SpacehuhnTech/HackHeld/README.md

# HackHeld

Here you can find all the hardware files for the HackHeld project. 

Visit [hackheld.spacehuhn.com](https://hackheld.spacehuhn.com) for more information.
