SpacehuhnTech/HackHeld/HackHeld Vega/Hackheld_Vega_Case/Hackheld_Vega_Case.stl

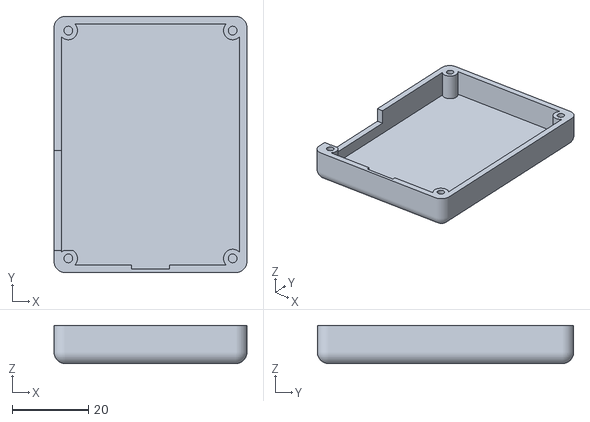
[picture p4: CAD file, 2021-08-06]
HackHeld Vega/Hackheld_Vega_Case/Hackheld_Vega_Case.stl
50.5 x 67.1 x 9.99
