SpacehuhnTech/HackHeld/HackHeld Vega/Hackheld_Vega_PCB/3D/OLED.step

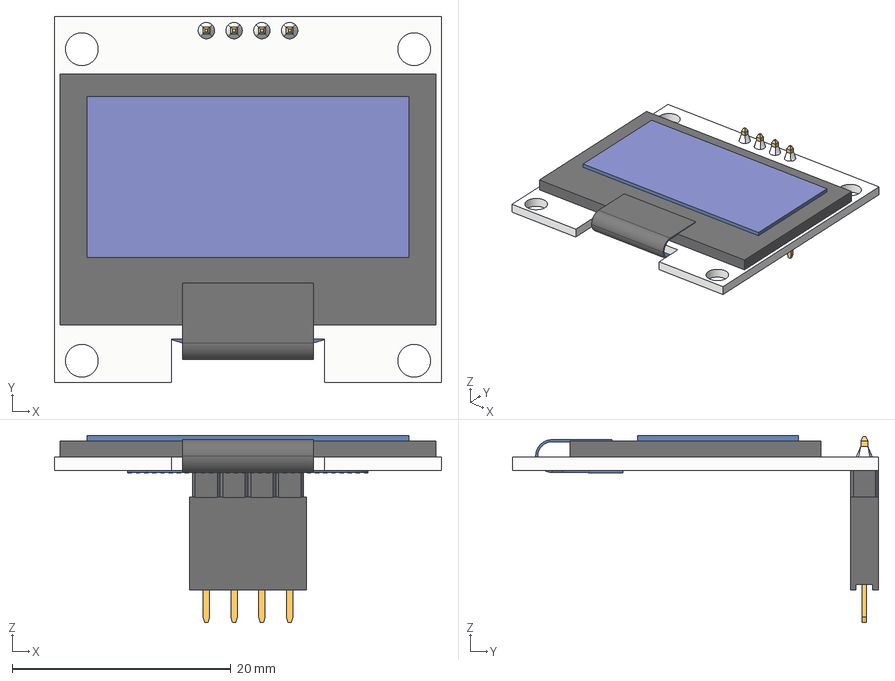
[picture p5: CAD file, 2021-08-06]
HackHeld Vega/Hackheld_Vega_PCB/3D/OLED.step
35.4 x 33.5 x 17.1 mm
Board
PIN HEADER MALE 2.54MM P4
LCD
FLEX FILM
4 lü Lehim
PIN HEADER FAMALE 2.54MM P4
