SpacehuhnTech/HackHeld/HackHeld Vega/Hackheld_Vega_PCB/3D/D1_mini_LiPo_Shield.step

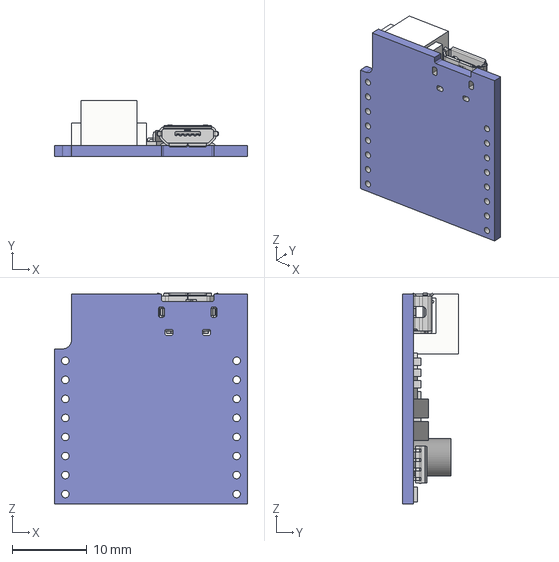
[picture p6: CAD file, 2021-08-06]
HackHeld Vega/Hackheld_Vega_PCB/3D/D1_mini_LiPo_Shield.step
25.8 x 7.50 x 28.2 mm
