SpacehuhnTech/HackHeld/(threads)

Thread 1 (2021-08-08):

i made one too，- ̗̀(๑ᵔ⌔ᵔ๑)

Froster69, 2021-08-08:
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

spacehuhn, 2021-08-09:
Fancy!

LZ2DMV, 2021-09-22:
Hey @Froster69 ,

Can you please share your PCB design and list of components?

Many thanks in advance!

Sajidamali, 2024-05-15:
Sir pleas muje wifi hacked kar ne wala weapon chiea pleas

Sajidamali, 2024-05-15:
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

Thread 2 (2021-09-20):

Using the left and right buttons?

LZ2DMV, 2021-09-20:
Hello,

How can i use the left and right buttons on my Hackheld Vega?

According to the board print, they are on D0 and D7, which are 16 and 13 [microcontroller pins](https://github.com/esp8266/Arduino/blob/612e7ffd7fb398fc2cdcf8bd1d177b75d997d46c/variants/d1_mini/pins_arduino.h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) respectively.

I tried adding this to the Button block in [A_config.h](https://github.com/SpacehuhnTech/esp8266_deauther/blob/bbe1b24e304853b1292a6eaa84a83a1b84ac0998/esp8266_deauther/A_config.h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):

```
#define BUTTON_LEFT 16 // D0
#define BUTTON_RIGHT 13 // D7
```

Then, using them in DisplayUI class:

```
void DisplayUI::setupButtons() {
(...)
leftBtn  = new ButtonPullup(BUTTON_LEFT);
rightBtn = new ButtonPullup(BUTTON_RIGHT);
(...)
```

```
// === BUTTON LEFT === //
leftBtn->setOnClicked([this]() {
scan.stop();
});
```

That doesn't work, though - nothing happens on button press.

WiFiFucker, 2021-11-07:
Sir GPIO16 (D0) is the one pin that is not suitable for buttons. :) It can be used as an output only and has the special role of sending a wakeup signal during deepsleep.

I find this web page handy as a reference for stuff like this: ESP8266 Pinout Reference: Which GPIO pins should you use? | Random Nerd Tutorials

You can add a resistor to fix this :)

LZ2DMV, 2021-11-07:
Yes, i see.

It is probably a good idea for @spacehuhn to correct that in the PCB design.

Thread 4 (2021-11-01):

OLED to PCB Pinout Conflict

ItsKarlito, 2021-11-01:
The README.md file shows the following pinout for the OLED:
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

The current KiCAD PCB file shows the following pinout:
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

ItsKarlito, 2021-11-05:
@spacehuhn i'm closing this as it has been resolved in the latest [commit](https://github.com/SpacehuhnTech/Hackheld/commit/a618aacdd4670db3354c16721fc29685005606c0)

Closed 2021-11-05.

Thread 6 (2022-06-03):

Can you share this project diagram please sir,,,sent diagram photo

TuserAhammed, 2022-06-03:
Can you share this project diagram please sir,,,sent diagram photo
![Uploading IMG_20220603_105155.jpg…]()

TuserAhammed, 2022-06-03:
Sent wire diagram please,, because i don't have money for pcb board making,, please sir

Thread 7 (2022-10-20):

Display flip

Szprej0, 2022-10-20:
Hi, I'm using Hackheld firmware on my NodeMCU and I have a different display position (flipped upside down). Can I flip the display in the firmware? I was using a (.bin) file to program

super-octol-tool, 2022-11-02:
Sorry don't know much about the NodeMCU and Hackheld firmware is pretty advanced for someone like U. You need to read some more. I'll get to you......Please note that the ESP8266 does only support 2.4GHz you need not creat fake networks if you have three or four devices which you can link together .

Szprej0, 2022-11-03:
Never mind i just downloaded the Arduino version and modified it to my preferences.

Closed 2022-11-03.
