SpacehuhnTech/HackHeld/(commit log)

2021-08-06 So far so good
    [D1_mini_LiPo_Shield.step, Hackheld_Vega.kicad_pcb, Hackheld_Vega.sch, Hackheld_Vega_Case.scad, Hackheld_Vega_Case.stl, OLED.step]
2021-08-06 PCB Download link
2021-11-03 Forgotten changes
    Looks like I made updates t the design without ever pushing it ¯\_(ツ)_/¯
    [Hackheld_Vega.kicad_pcb, Hackheld_Vega.sch]
2021-11-27 Fix gerber files link
2023-05-03 Move into sub folder
    [D1_mini_LiPo_Shield.step, Hackheld_Vega.kicad_pcb, Hackheld_Vega.sch, Hackheld_Vega_Case.scad, Hackheld_Vega_Case.stl, OLED.step]
2023-05-03 HackHeld Vega II
    [Hackheld_Vega.kicad_pcb, Hackheld_Vega.kicad_sch]
2024-02-02 HackHeld Bat Mod PCB Files
    [Hackheld_Vega.kicad_pcb, Hackheld_Vega_LiPo.kicad_pcb, Hackheld_Vega_LiPo.kicad_sch]
